AGarcesS/CPLDTest/doc/placa_test/placa_test_esquema.pdf

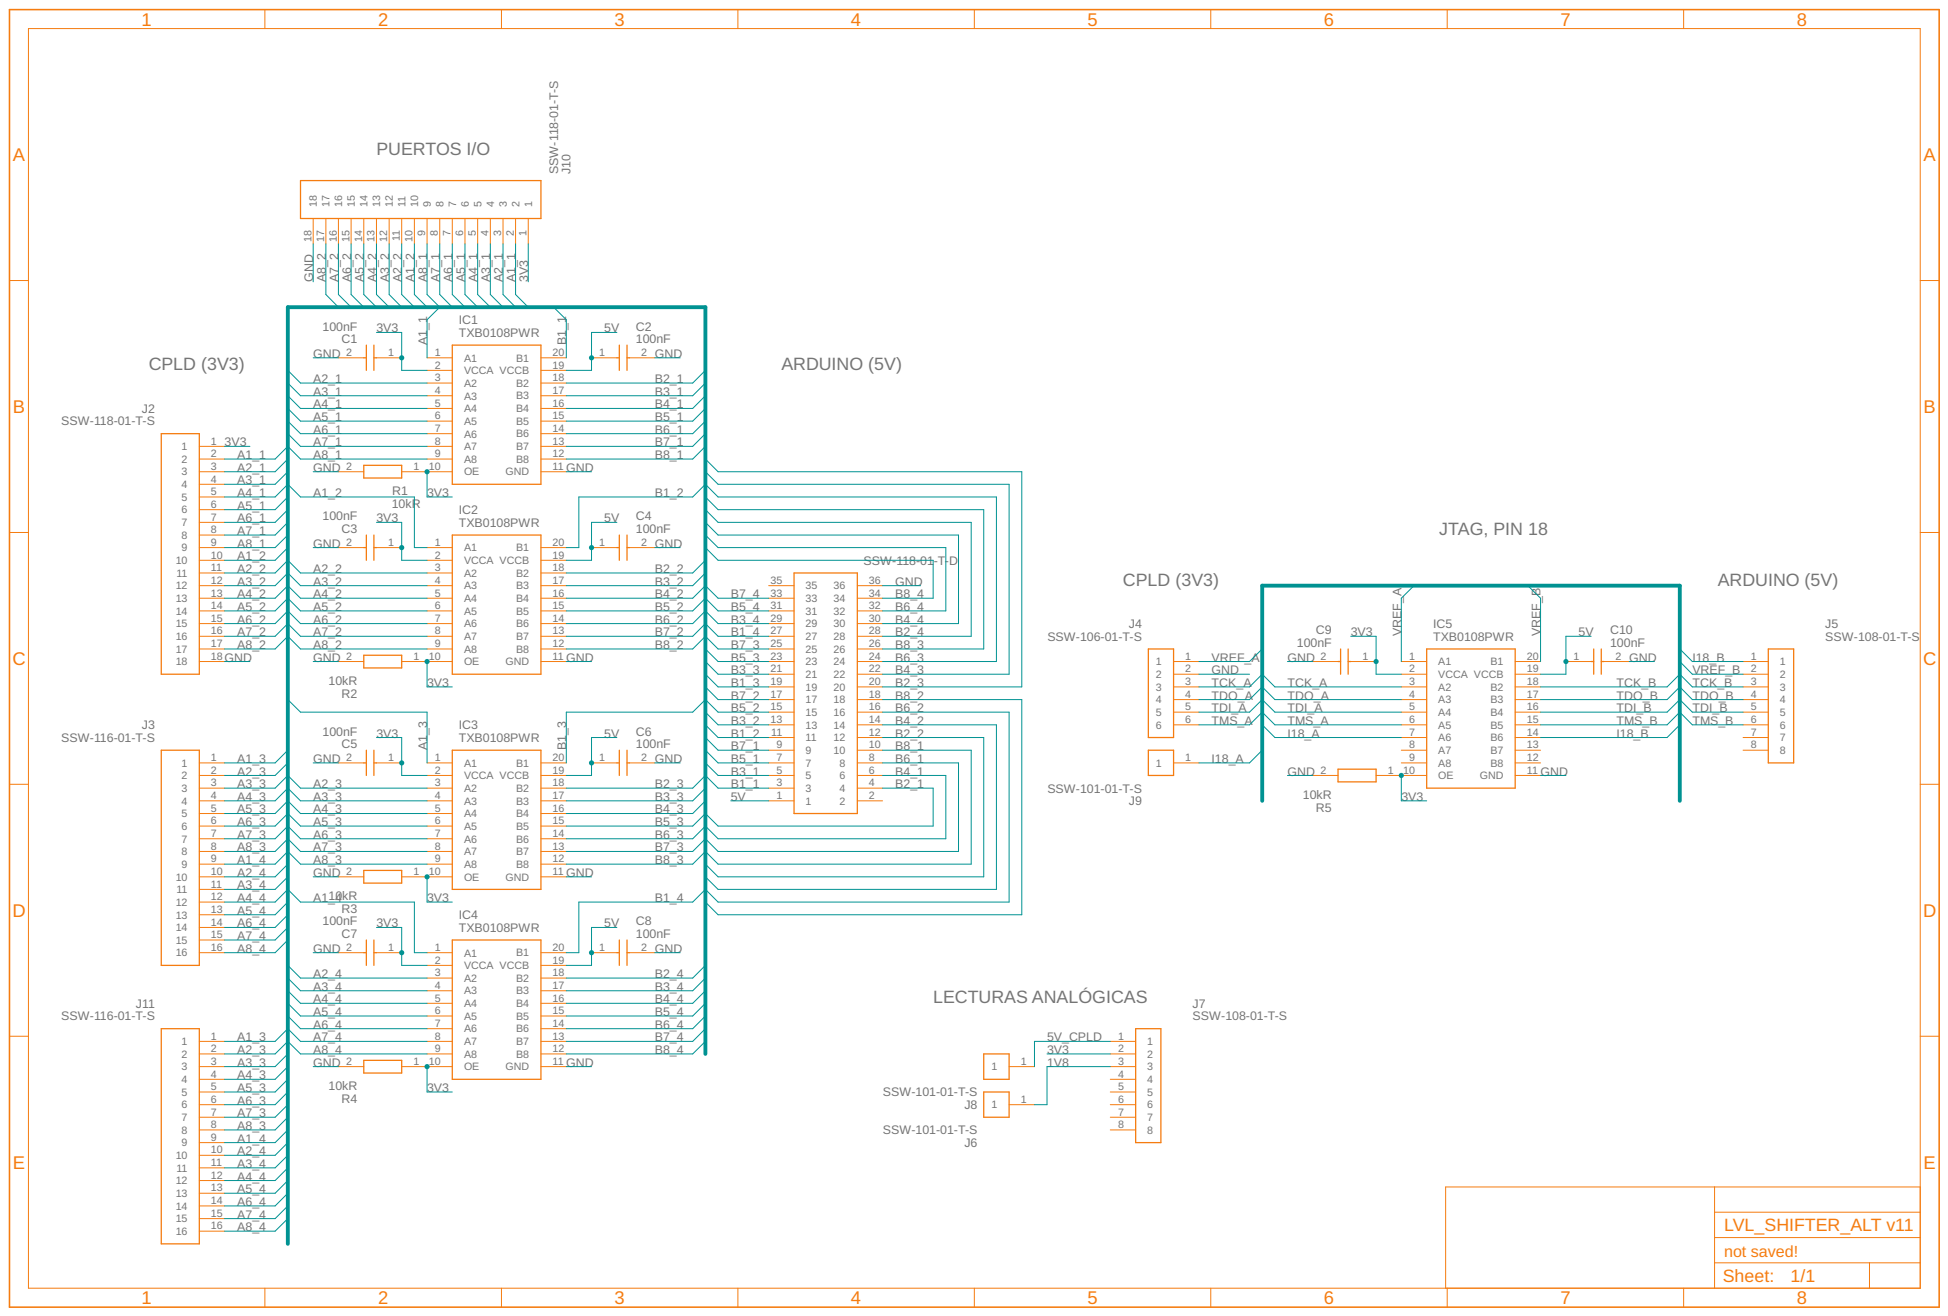
[picture p13: page 1]
