AGarcesS/CPLDTest/doc/placa_test/placa_test_inferior.pdf

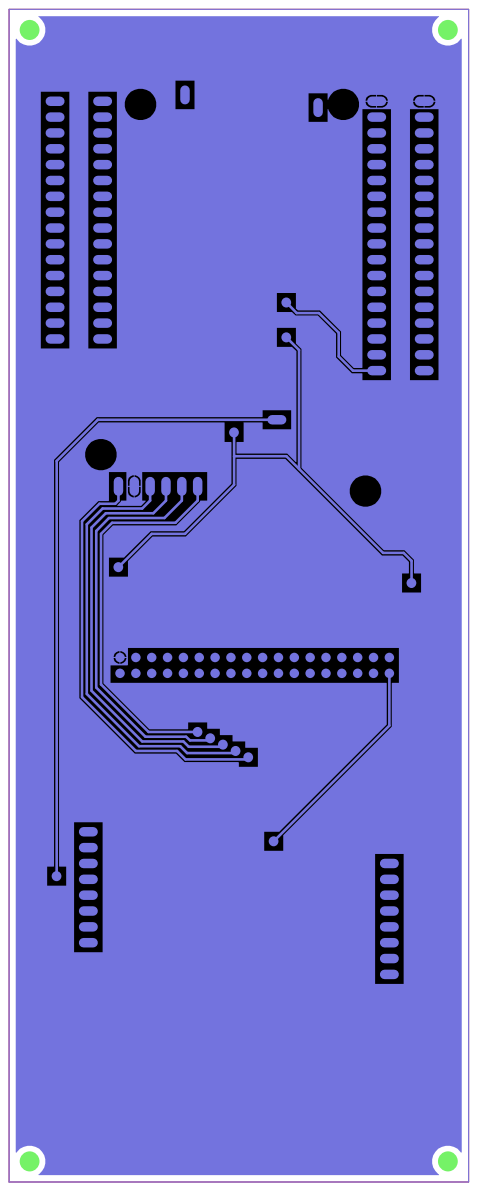
[picture p14: page 1]
