AGarcesS/CPLDTest/doc/placa_test/placa_test_superior.pdf

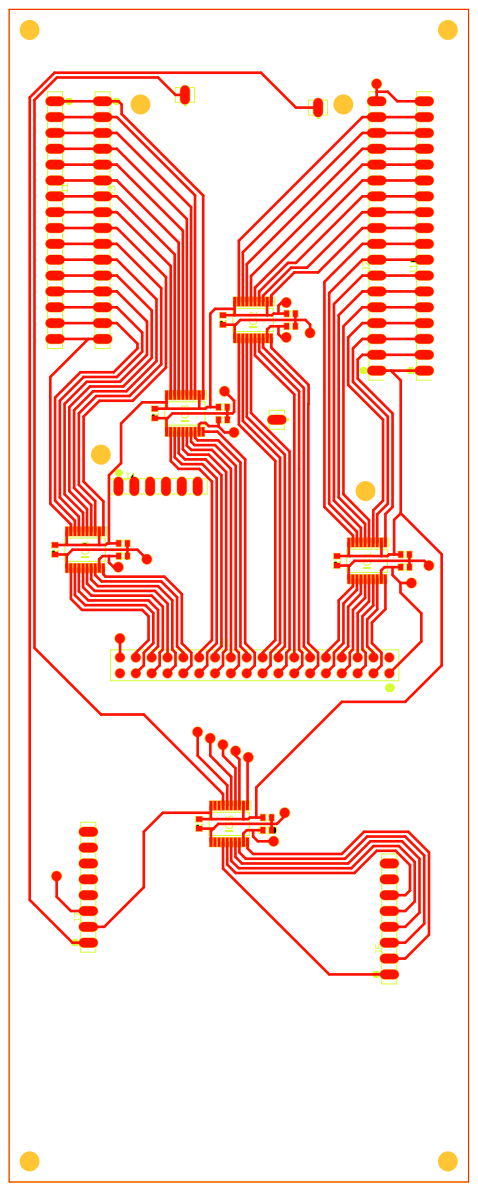
[picture p15: page 1]
