AGarcesS/CPLDTest/doc/placa_cpld/placa_cpld_esquema.pdf

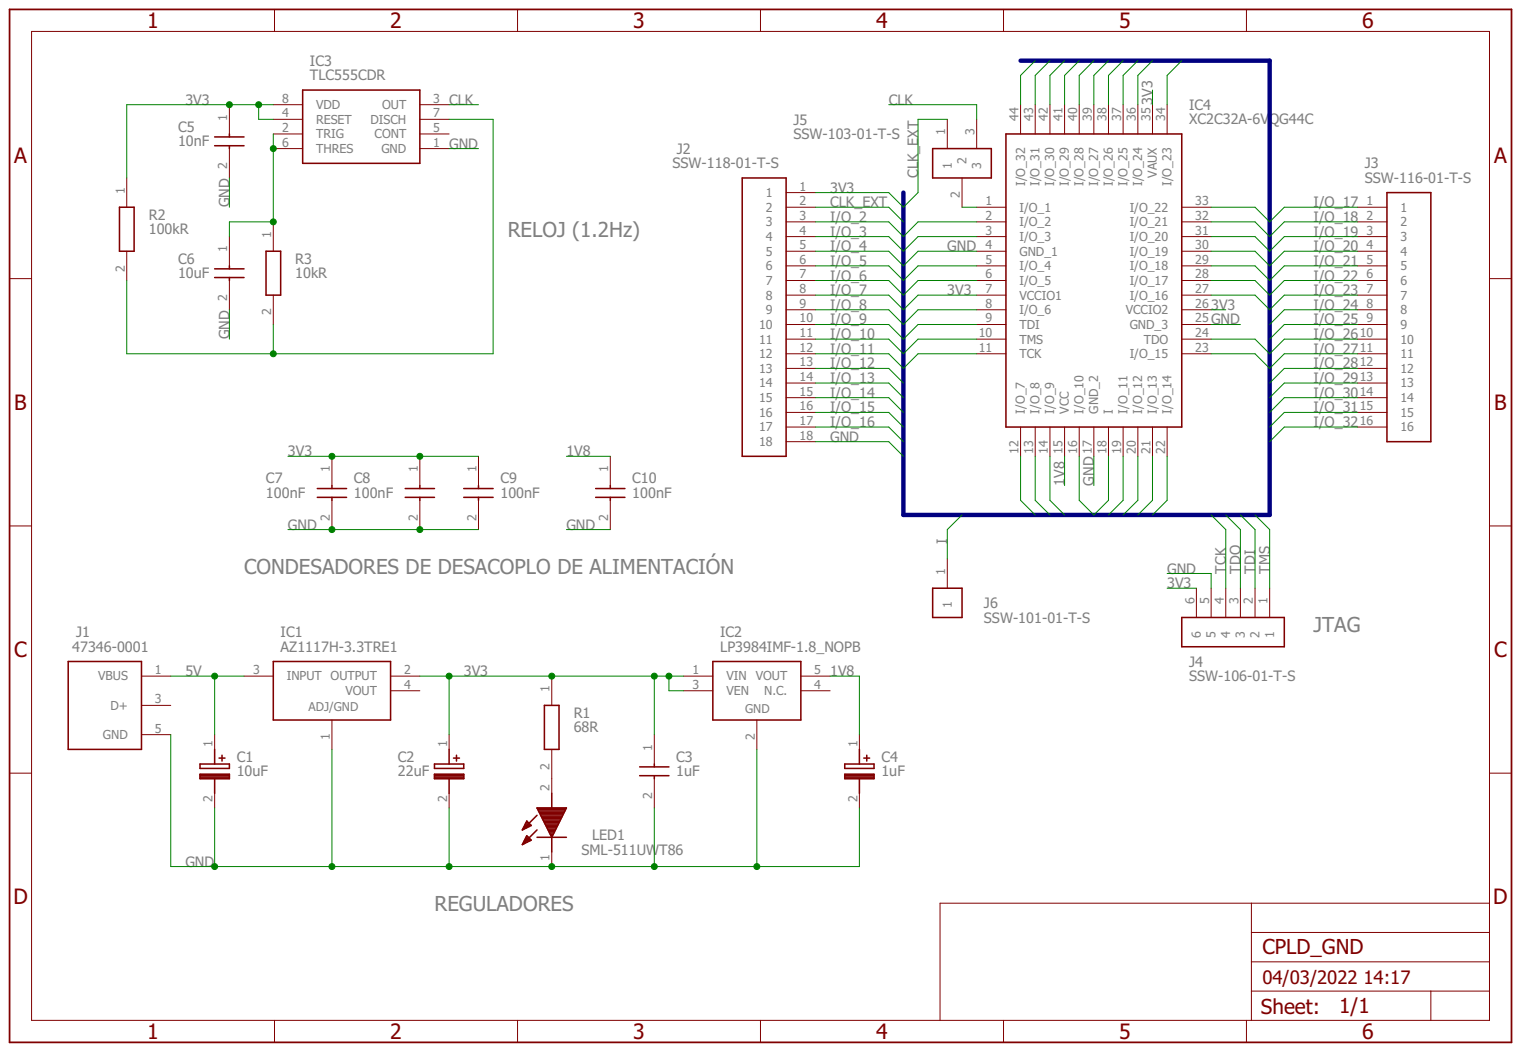
[picture p16: page 1]

CONDESADORES DE DESACOPLO DE ALIMENTACIÓN
