AGarcesS/CPLDTest/doc/placa_cpld/placa_cpld_inferior.pdf

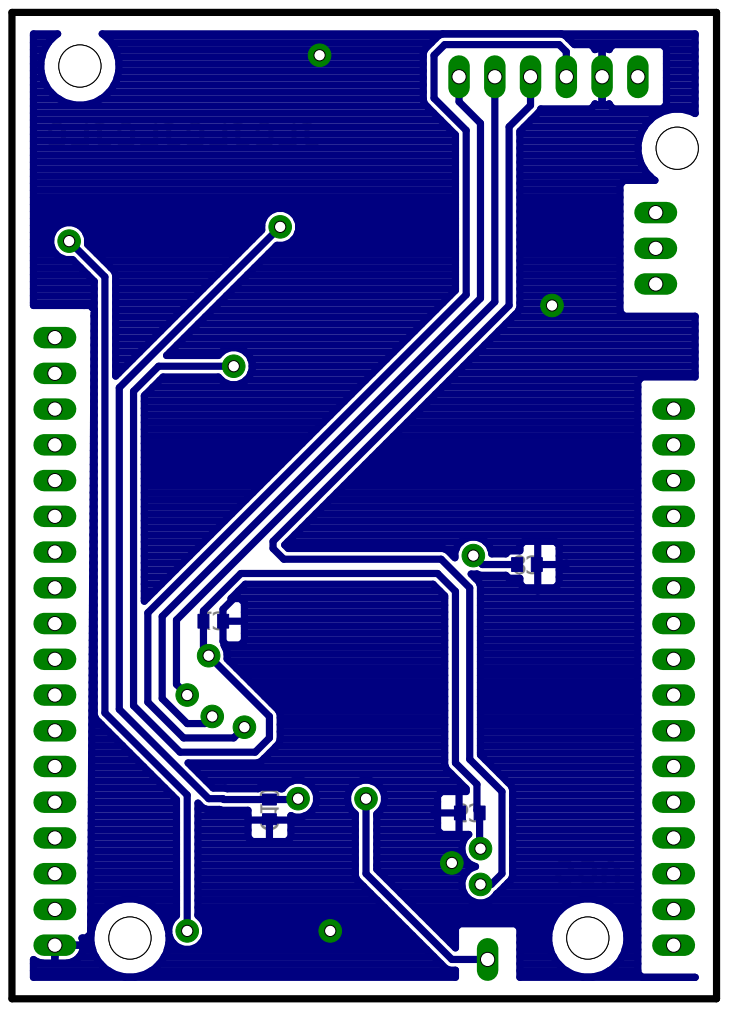
[picture p17: page 1]
