AGarcesS/CPLDTest/doc/placa_cpld/placa_cpld_superior.pdf

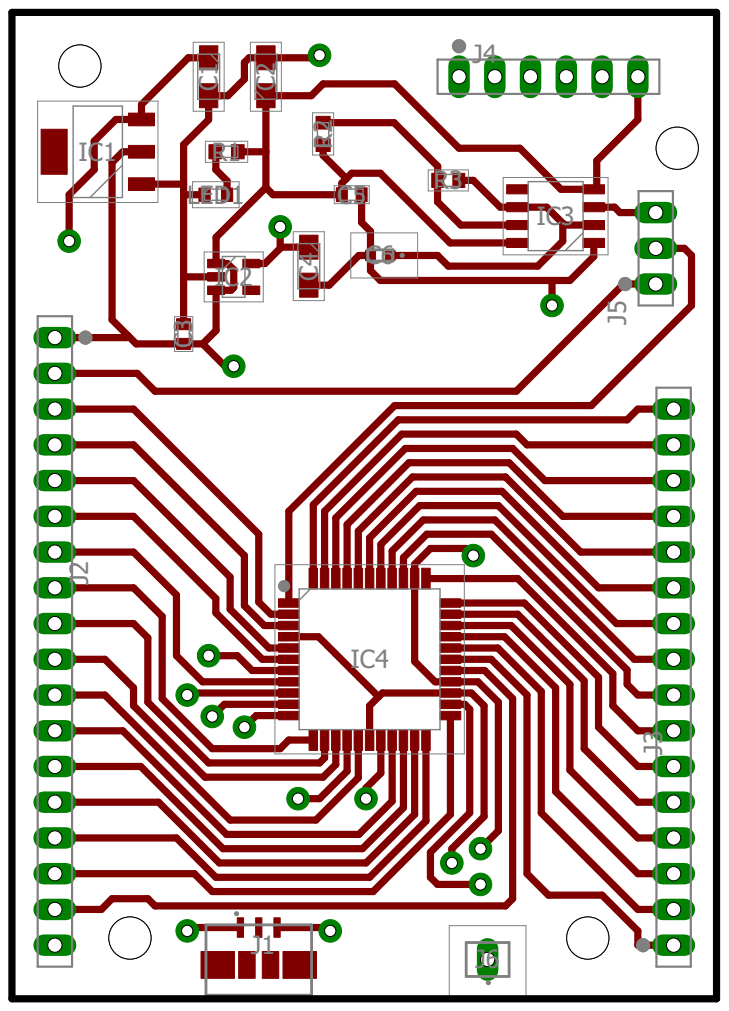
[picture p18: page 1]
