AGarcesS/CPLDTest/doc/soporte/soporte_inferior.pdf

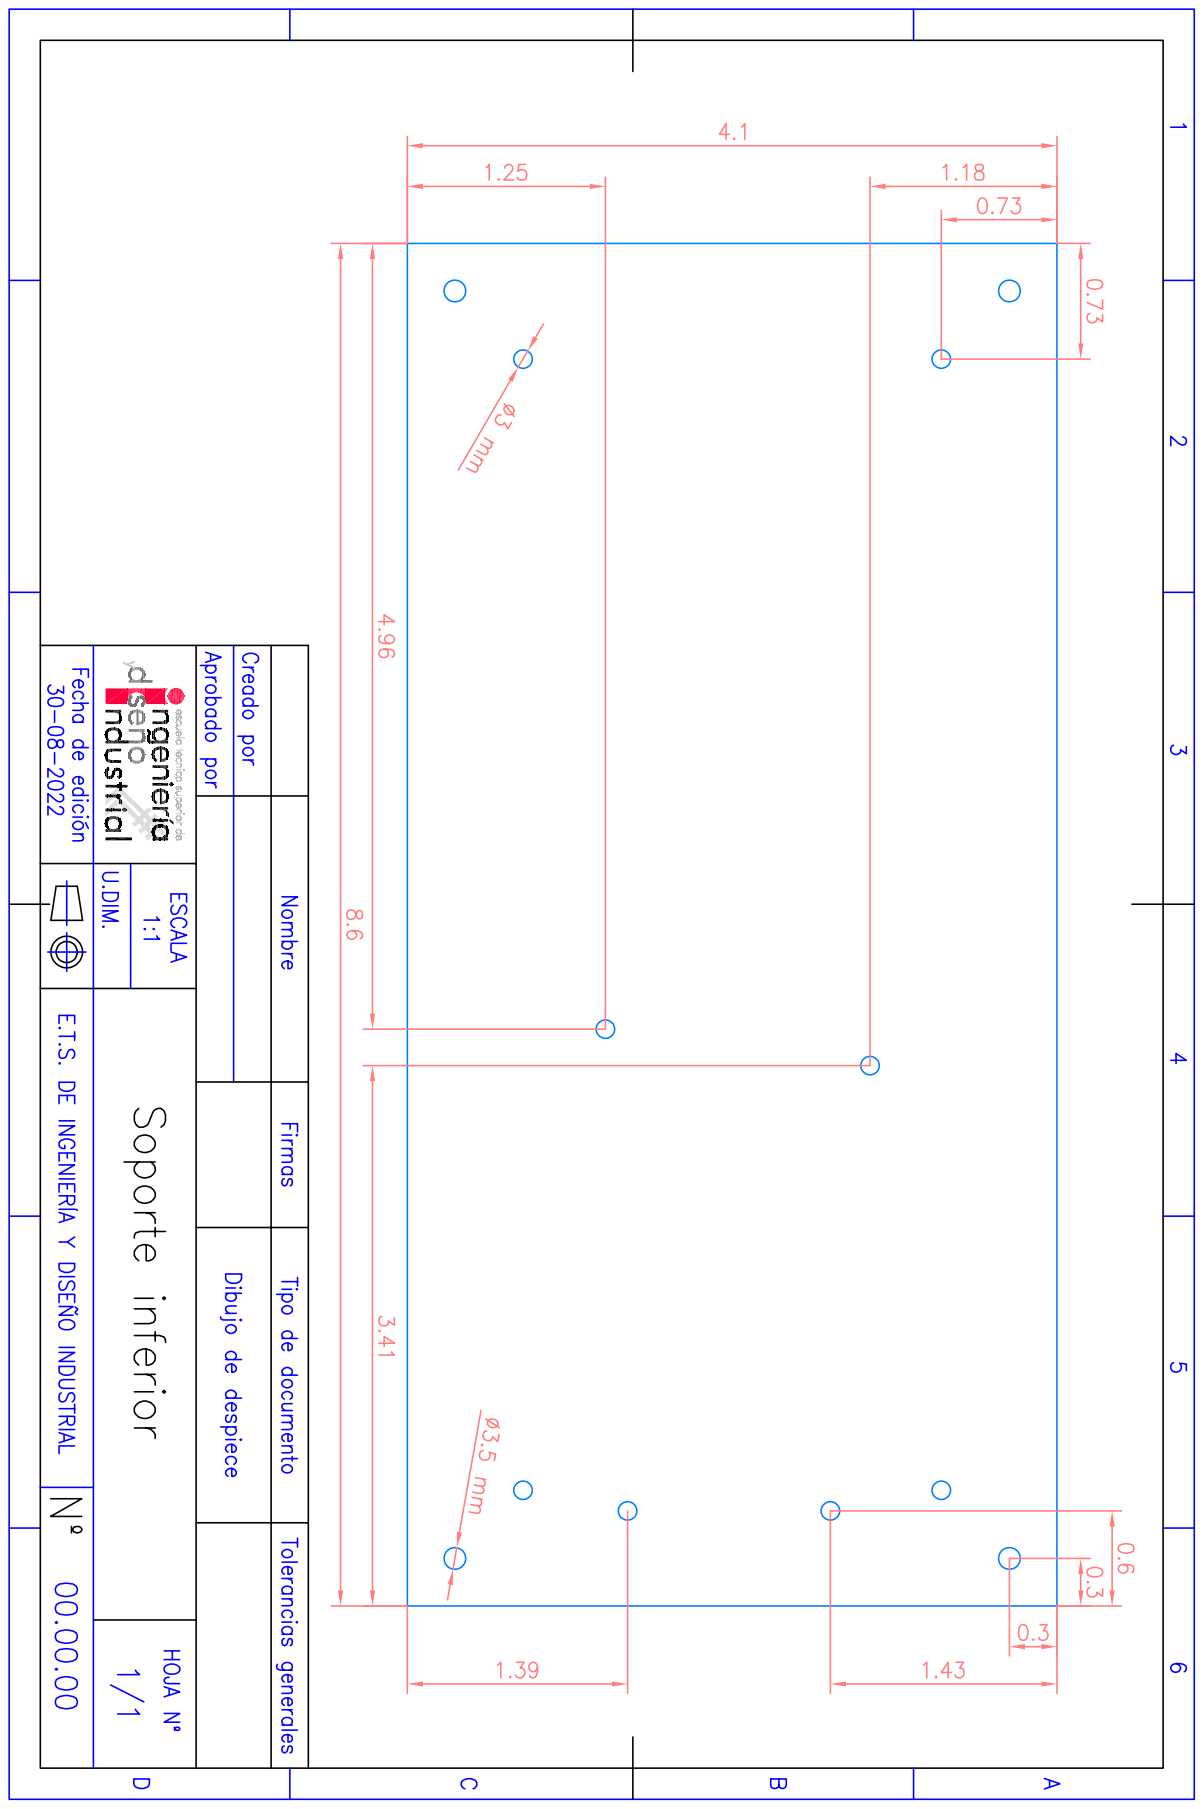
[picture p19: page 1]
