AGarcesS/CPLDTest/doc/soporte/soporte_superior.pdf

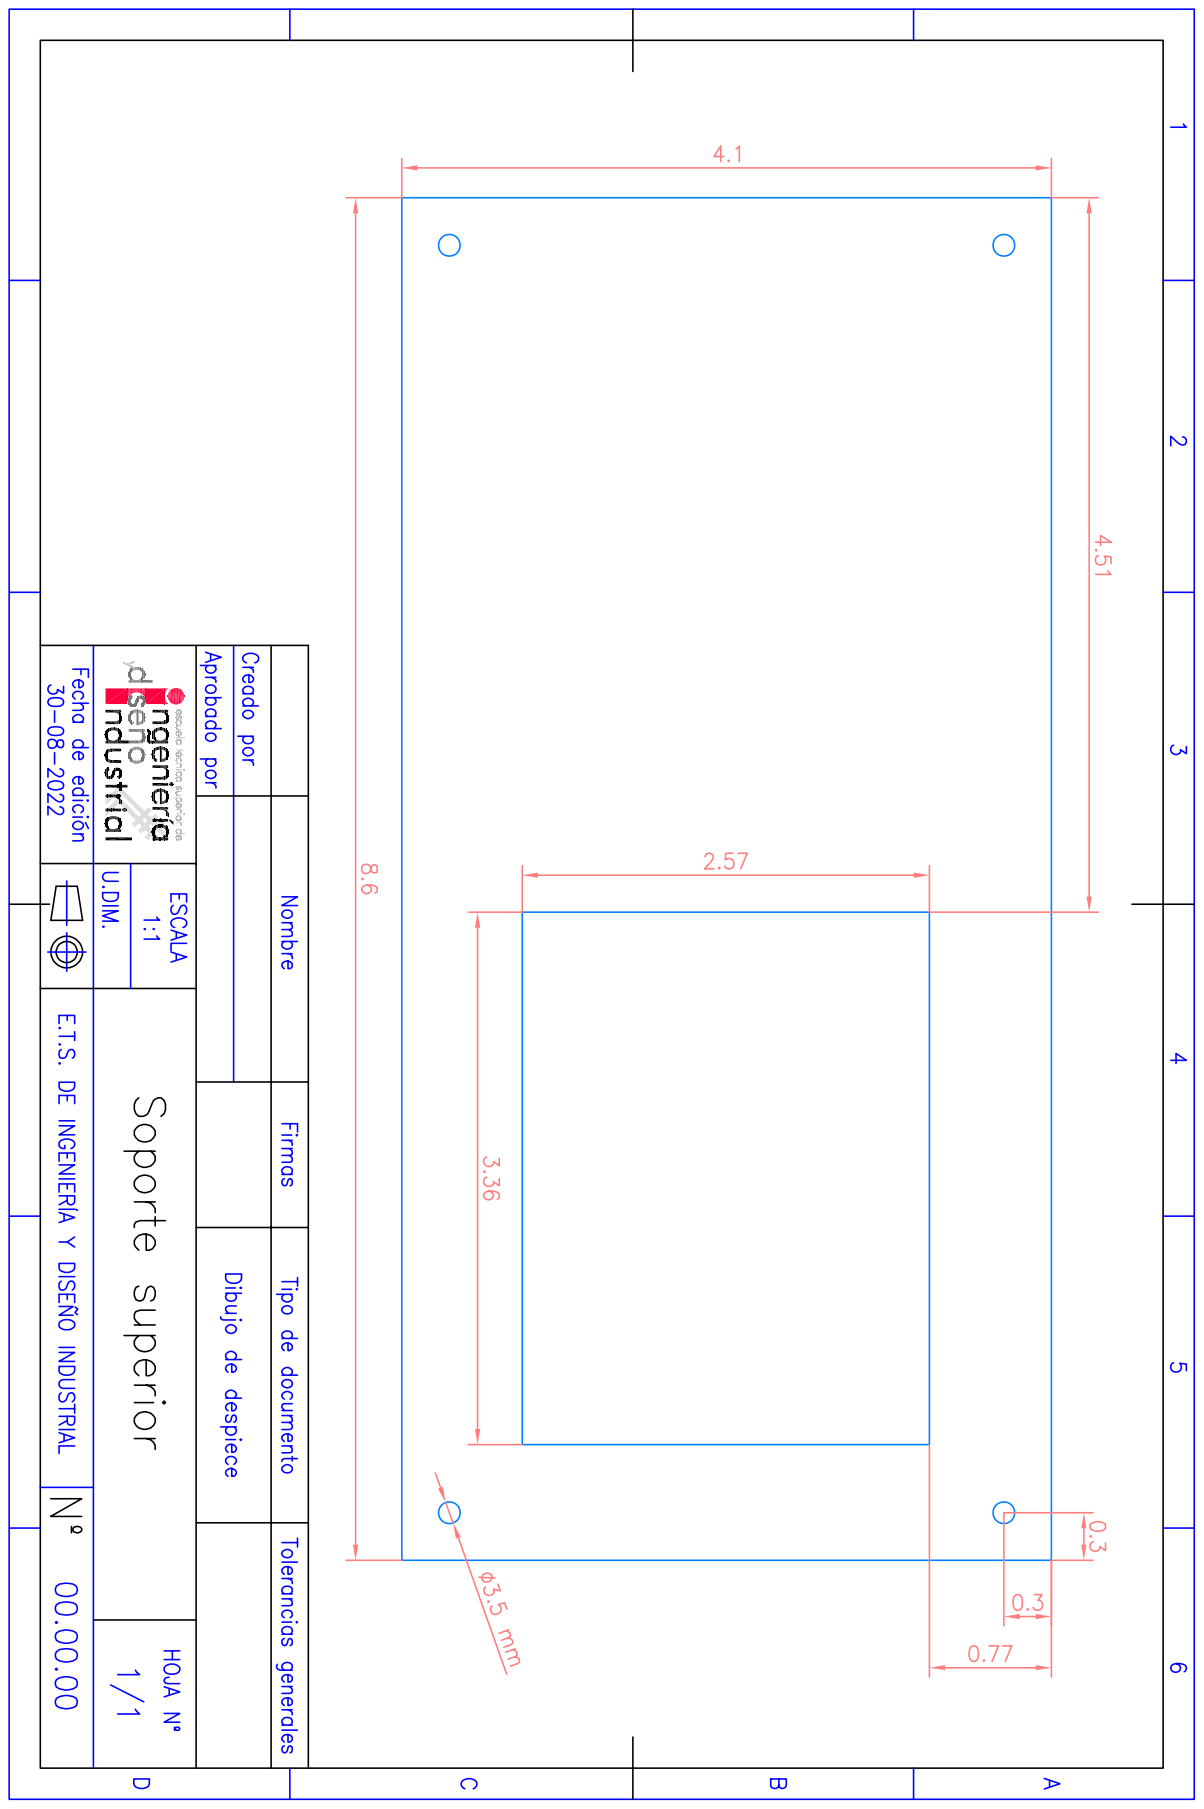
[picture p20: page 1]
