AGarcesS/CPLDTest/doc/placa_cpld/eagle/CPLD.brd

## EAGLE design doc/placa_cpld/eagle/CPLD.brd (2025-02-26)

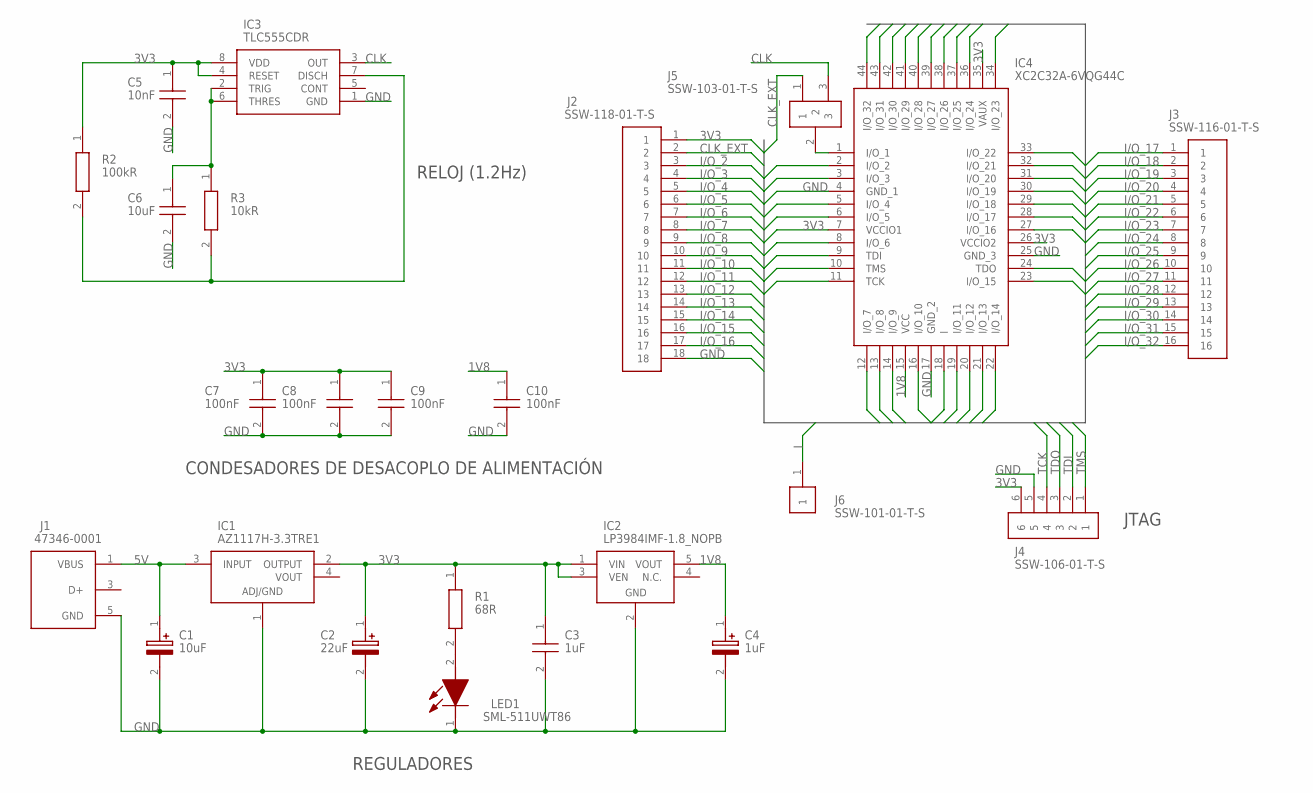
[picture p21: schematic CPLD.sch]

Parts:
C1: 10uF; CAPPM3216X180N
C2: 22uF; CAPPM3216X180N
C3: 1uF; CAPC1608X90N
C4: 1uF; CAPPM3216X180N
C5: 10nF; CAPC1608X87N
C6: 10uF; C1608_COMMERCIAL
C7, C8, C9, C10: 100nF; CAPC1608X95N
IC1: AZ1117H-3.3TRE1; SOT230P700X180-4N
IC2: LP3984IMF-1.8_NOPB; SOT95P280X145-5N
IC3: TLC555CDR; SOIC127P600X175-8N
IC4: XC2C32A-6VQG44C; QFP80P1200X1200X120-44N
J1: 47346-0001
J2: SSW-118-01-T-S; SAMTEC_SSW-118-01-T-S
J3: SSW-116-01-T-S; SAMTEC_SSW-116-01-T-S
J4: SSW-106-01-T-S; SAMTEC_SSW-106-01-T-S
J5: SSW-103-01-T-S; SAMTEC_SSW-103-01-T-S
J6: SSW-101-01-T-S; SSW-101-XX-YYY-S
LED1: SML-511UWT86; LEDC1608X65N
R1: 68R; RESC1608X55N
R2: 100kR; RESC1608X55N
R3: 10kR; RESC1608X50N

Connections:
1V8: C4.1 (+), C10.1, IC2.5 (VOUT), IC4.15 (VCC)
3V3: C2.1 (+), C3.1, C5.1, C7.1, C8.1, C9.1, IC1.2 (OUTPUT), IC2.1 (VIN), IC2.3 (VEN), IC3.4 (RESET), IC3.8 (VDD), IC4.7 (VCCIO1), IC4.26 (VCCIO2), IC4.35 (VAUX), J2.1, J4.6, R1.1, R2.1
5V: C1.1 (+), IC1.3 (INPUT), J1.1 (VBUS)
CLK: IC3.3 (OUT), J5.3
CLK_EXT: J2.2, J5.1
GND: C1.2 (-), C2.2 (-), C3.2, C4.2 (-), C5.2, C6.2, C7.2, C8.2, C9.2, C10.2, IC1.1 (ADJ/GND), IC2.2 (GND), IC3.1 (GND), IC4.4 (GND_1), IC4.17 (GND_2), IC4.25 (GND_3), J1.5 (GND), J2.18, J4.5, LED1.1 (K)
I: IC4.18 (I), J6.1
I/O_2: IC4.2 (I/O_2), J2.3
I/O_3: IC4.3 (I/O_3), J2.4
I/O_4: IC4.5 (I/O_4), J2.5
I/O_5: IC4.6 (I/O_5), J2.6
I/O_6: IC4.8 (I/O_6), J2.7
I/O_7: IC4.12 (I/O_7), J2.8
I/O_8: IC4.13 (I/O_8), J2.9
I/O_9: IC4.14 (I/O_9), J2.10
I/O_10: IC4.16 (I/O_10), J2.11
I/O_11: IC4.19 (I/O_11), J2.12
I/O_12: IC4.20 (I/O_12), J2.13
I/O_13: IC4.21 (I/O_13), J2.14
I/O_14: IC4.22 (I/O_14), J2.15
I/O_15: IC4.23 (I/O_15), J2.16
I/O_16: IC4.27 (I/O_16), J2.17
I/O_17: IC4.28 (I/O_17), J3.1
I/O_18: IC4.29 (I/O_18), J3.2
I/O_19: IC4.30 (I/O_19), J3.3
I/O_20: IC4.31 (I/O_20), J3.4
I/O_21: IC4.32 (I/O_21), J3.5
I/O_22: IC4.33 (I/O_22), J3.6
I/O_23: IC4.34 (I/O_23), J3.7
I/O_24: IC4.36 (I/O_24), J3.8
I/O_25: IC4.37 (I/O_25), J3.9
I/O_26: IC4.38 (I/O_26), J3.10
I/O_27: IC4.39 (I/O_27), J3.11
I/O_28: IC4.40 (I/O_28), J3.12
I/O_29: IC4.41 (I/O_29), J3.13
I/O_30: IC4.42 (I/O_30), J3.14
I/O_31: IC4.43 (I/O_31), J3.15
I/O_32: IC4.44 (I/O_32), J3.16
unnamed: C6.1, IC3.2 (TRIG), IC3.6 (THRES), R3.1
unnamed: LED1.2 (A), R1.2
unnamed: IC3.7 (DISCH), R2.2, R3.2
unnamed: IC4.1 (I/O_1), J5.2
TCK: IC4.11 (TCK), J4.4
TDI: IC4.9 (TDI), J4.2
TDO: IC4.24 (TDO), J4.3
TMS: IC4.10 (TMS), J4.1

Notes on the sheet:
JTAG
RELOJ (1.2Hz)
CONDESADORES DE DESACOPLO DE ALIMENTACIÓN
REGULADORES

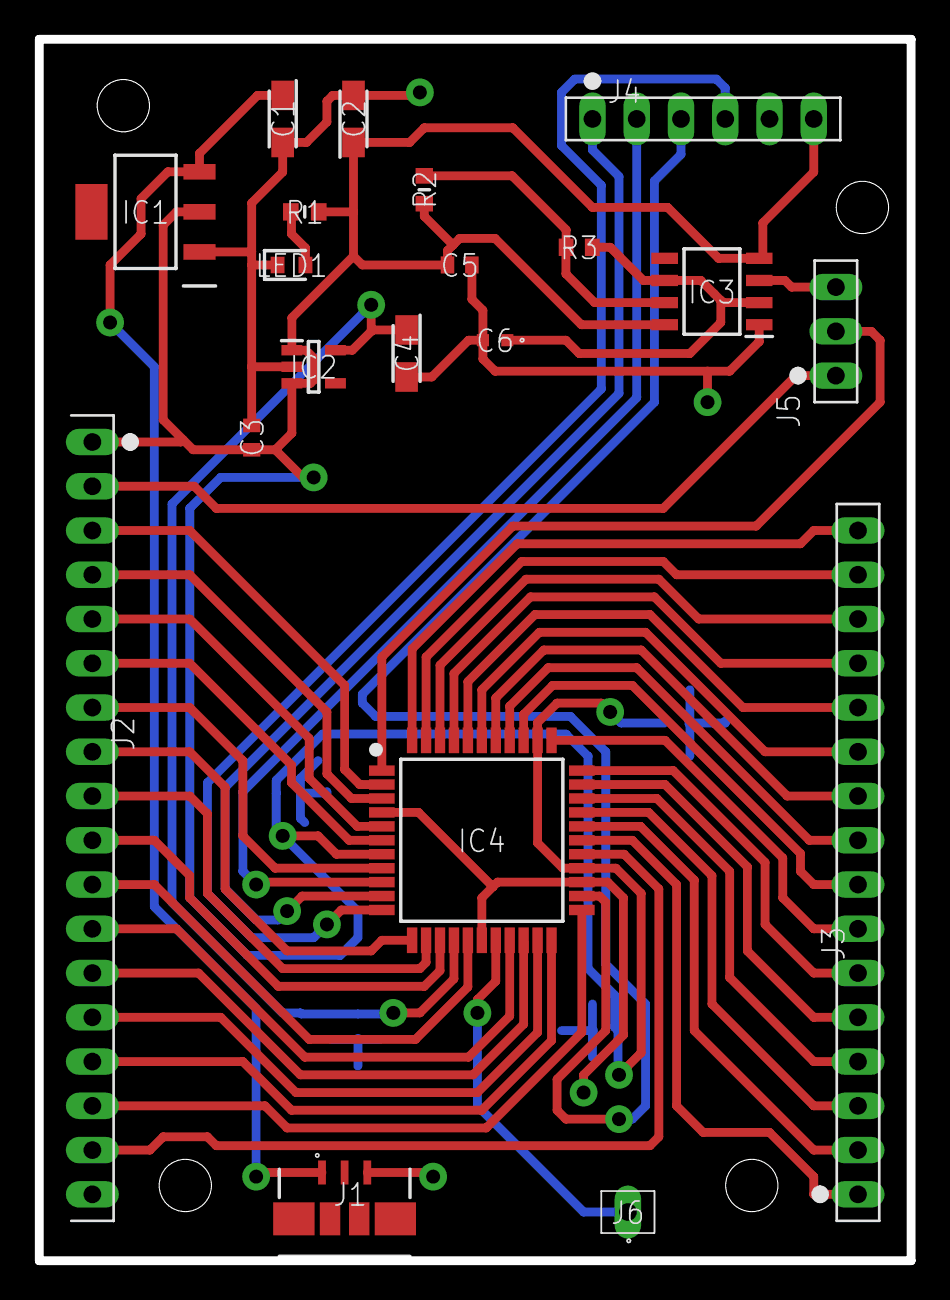
[picture p22: board CPLD.brd from above]

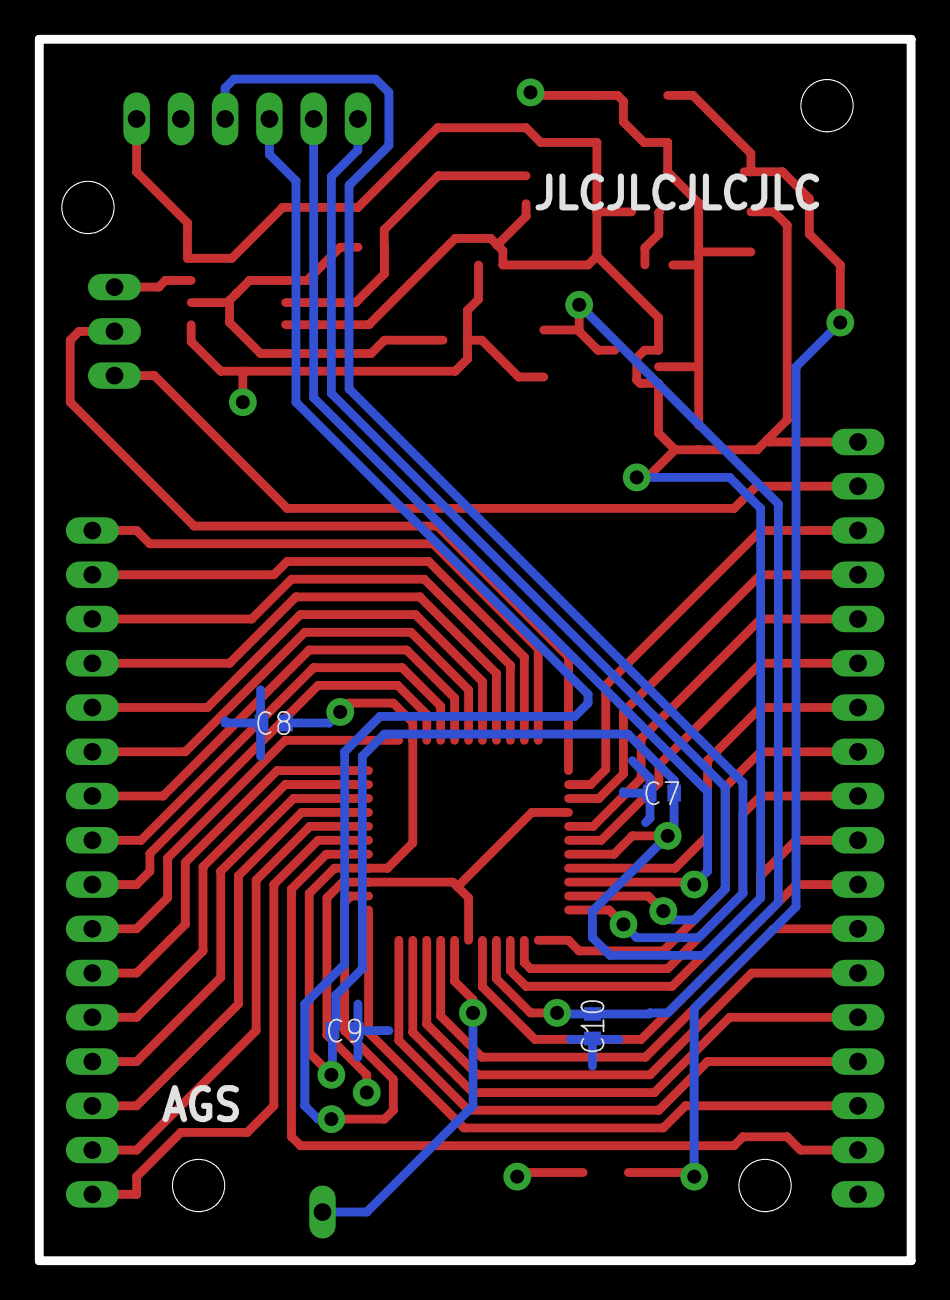
[picture p23: board CPLD.brd from below]

Board: 2 copper layers, 50.0 x 70.1 mm, 24 parts (4 on the bottom side), 46 nets.
