AGarcesS/CPLDTest/(commit log)

2022-08-31 Añadido: planos y esquemas de las placas y el soporte
2022-08-31 Añadido: proyecto rotate desarrollado en Xilinx ISE
    [rotate_pad.csv]
2022-09-07 Actualizado: corrección de test.ino y comentarios añadidos en Test.cpp
2022-09-07 Actualizado: corrección de rotate_tb.vhd
2022-09-17 Añadido: manual de instalación, Actualizado: cambio de nombre del directorio de documentación
2025-02-26 Añadido: ficheros de esquemático y rutado del proyecto en Eagle de la placa CPLD
    [CPLD.brd, CPLD.sch]
